M0WUT/Intermediate_PCBs/README.md

# Intermediate_PCBs
Selection of PCBs designed to help with the UK Intermediate Amateur Radio Licence practical requirements
