M0WUT/Intermediate_PCBs/schematic.pdf

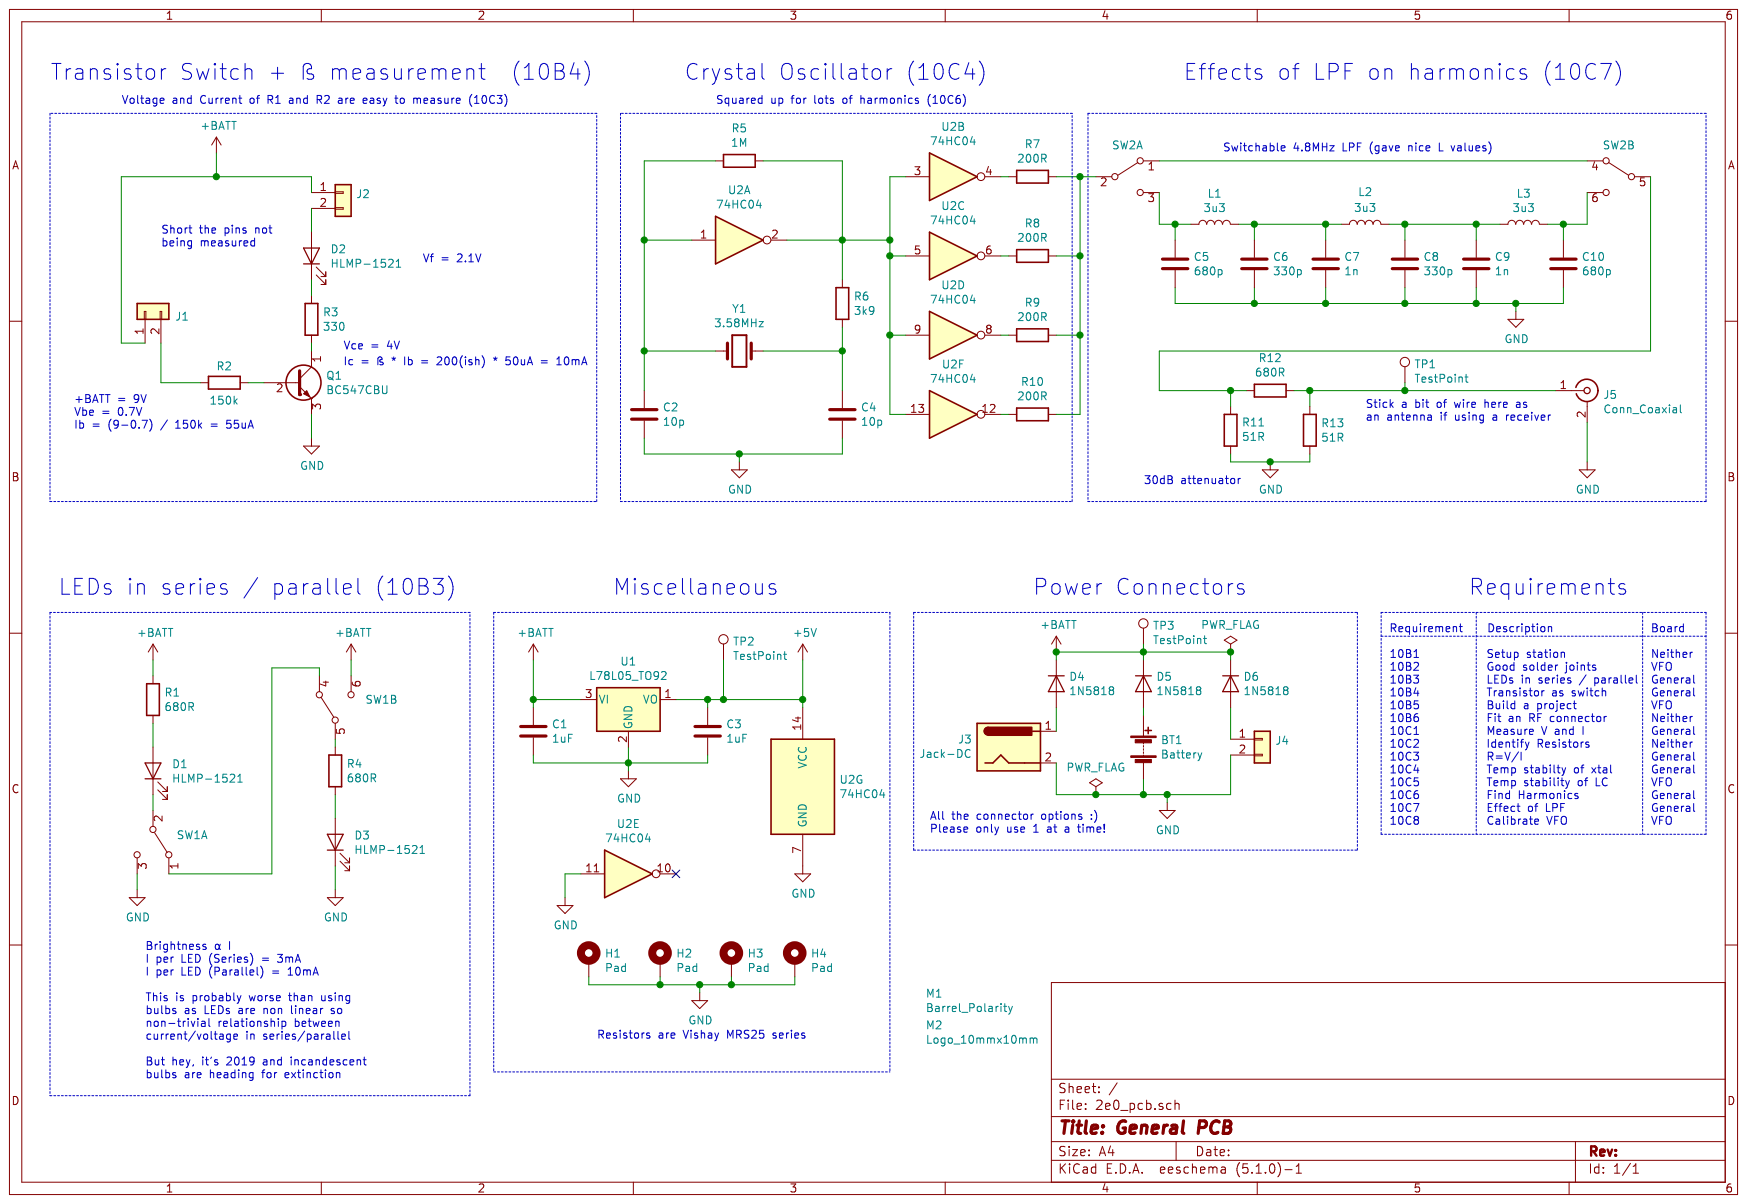
[picture p1: page 1]
