M0WUT/Intermediate_PCBs/2e0_pcb/2e0_pcb.kicad_pcb

## KiCad design 2e0_pcb/2e0_pcb.kicad_pcb (2019-10-28)

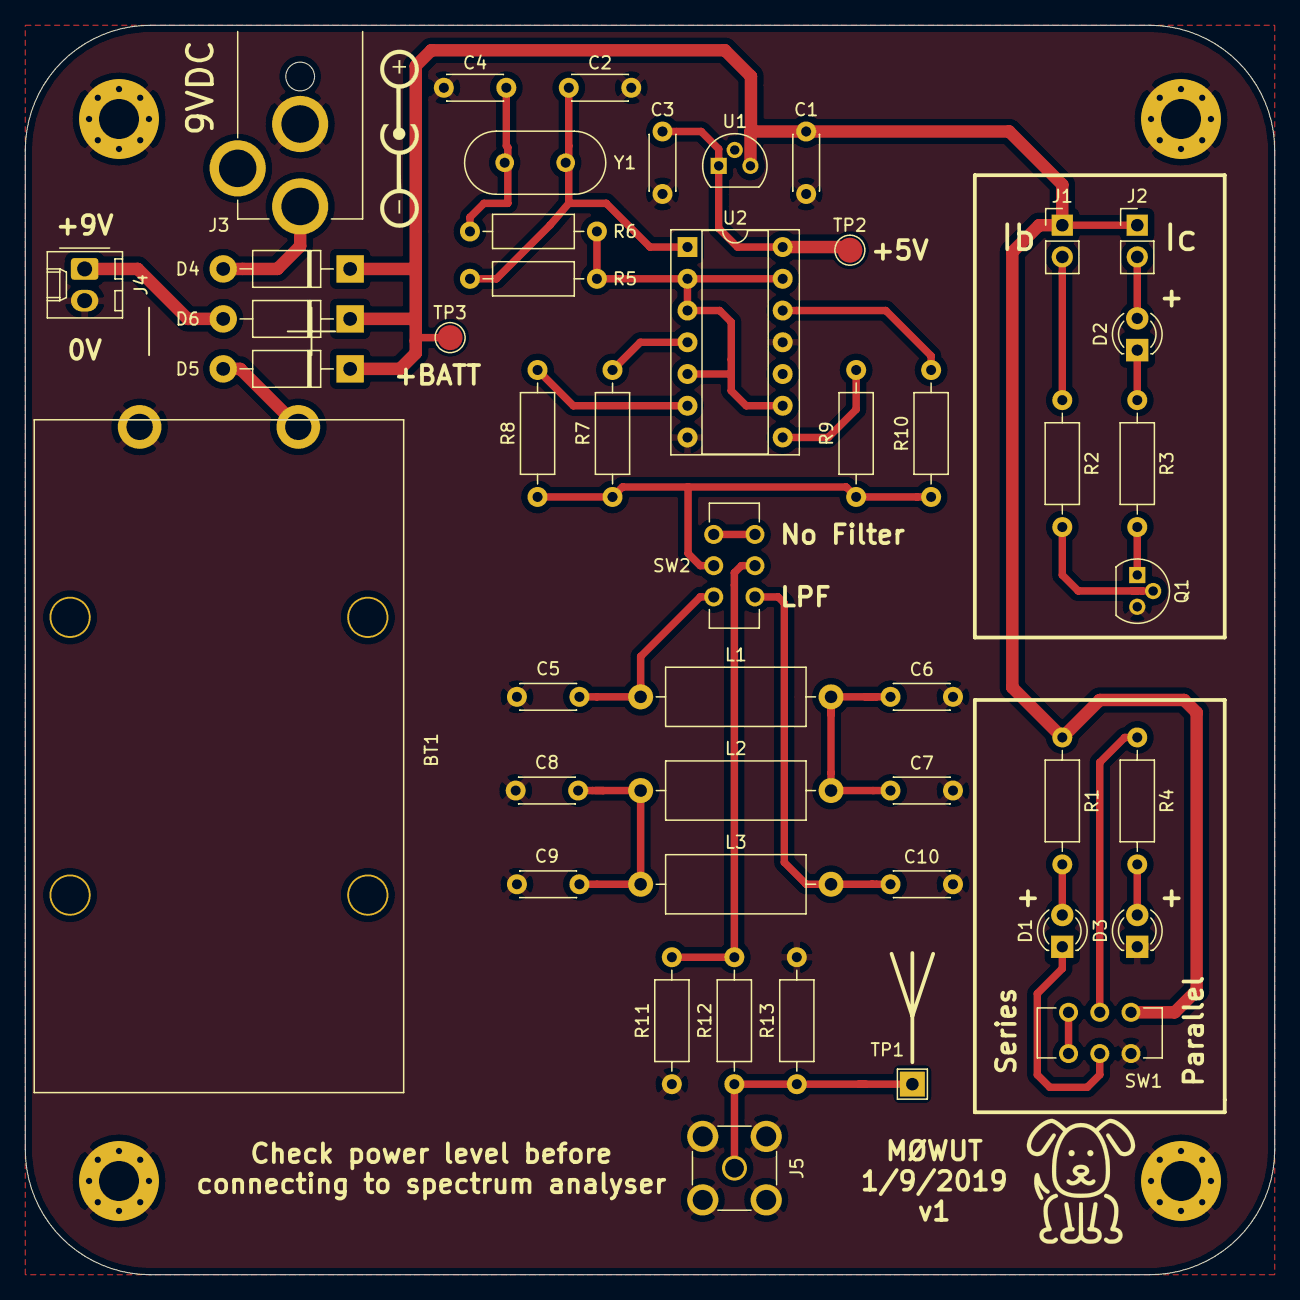
[picture p2: board 2e0_pcb.kicad_pcb from above]

Board: 2 copper layers, 100.0 x 100.0 mm, 53 parts (0 on the bottom side), 31 nets.

Parts:
BT1: Battery; Battery_PP3_Keystone_1294_TH
C1, C3: 1uF; C_Disc_D4.3mm_W1.9mm_P5.00mm
C2, C4: 10p; C_Disc_D4.3mm_W1.9mm_P5.00mm
C5, C10: 680p; C_Disc_D4.3mm_W1.9mm_P5.00mm
C6, C8: 330p; C_Disc_D4.3mm_W1.9mm_P5.00mm
C7, C9: 1n; C_Disc_D4.3mm_W1.9mm_P5.00mm
D1, D2, D3: HLMP-1521; LED_D3.0mm
D4, D5, D6: 1N5818; D_DO-41_SOD81_P10.16mm_Horizontal
H1, H2, H3, H4: Pad; MountingHole_3.2mm_M3_Pad_Via
J1, J2: Conn_01x02; PinHeader_1x02_P2.54mm_Vertical
J3: Jack-DC; Barrel-Jack_Cliff_FC681478_TH
J4: Conn_01x02; Molex_KK-254_AE-6410-02A_1x02_P2.54mm_Vertical
J5: Conn_Coaxial; SMA_TE_5-1814832-1_Vertical
L1, L2, L3: 3u3; L_Axial_L11.0mm_D4.5mm_P15.24mm_Horizontal_Fastron_MECC
M1: Barrel_Polarity
M2: Logo_10mmx10mm
Q1: BC547CBU; TO-92L
R1, R4, R12: 680R; R_Axial_DIN0207_L6.3mm_D2.5mm_P10.16mm_Horizontal
R2: 150k; R_Axial_DIN0207_L6.3mm_D2.5mm_P10.16mm_Horizontal
R3: 330; R_Axial_DIN0207_L6.3mm_D2.5mm_P10.16mm_Horizontal
R5: 1M; R_Axial_DIN0207_L6.3mm_D2.5mm_P10.16mm_Horizontal
R6: 3k9; R_Axial_DIN0207_L6.3mm_D2.5mm_P10.16mm_Horizontal
R7, R8, R9, R10: 200R; R_Axial_DIN0207_L6.3mm_D2.5mm_P10.16mm_Horizontal
R11, R13: 51R; R_Axial_DIN0207_L6.3mm_D2.5mm_P10.16mm_Horizontal
SW1, SW2: SW_DPDT_x2; C+K_Slide_DPDT_JS202011CQN_TH
TP1: TestPoint; TestPoint_THTPad_2.0x2.0mm_Drill1.0mm
TP2, TP3: TestPoint; TestPoint_Pad_D2.0mm
U1: L78L05_TO92; TO-92L
U2: 74HC04; DIP-14_W7.62mm_Socket
Y1: 3.58MHz; Crystal_HC49-U_Vertical

Connections:
+5V: C3.1, TP2.1, U1.1, U2.14
+BATT: C1.1, D4.1, D5.1, D6.1, J1.1, J2.1, R1.1, SW1.6, TP3.1, U1.3
GND: BT1.2, C1.2, C2.2, C3.2, C4.2, C5.2, C6.2, C7.2, C8.2, C9.2, C10.2, D3.1, H1.1, H2.1, H3.1, H4.1, J3.2, J4.2, J5.2, Q1.3, R11.1, R13.2, SW1.3, U1.2, U2.7, U2.11
unnamed: BT1.1, D5.2
unnamed: C2.1, R5.2, U2.1, Y1.1
unnamed: C4.1, R6.2, Y1.2
unnamed: C5.1, L1.1, SW2.3
unnamed: C6.1, C7.1, L1.2, L2.2
unnamed: C8.1, C9.1, L2.1, L3.1
unnamed: C10.1, L3.2, SW2.6
unnamed: D1.1, SW1.2
unnamed: D1.2, R1.2
unnamed: D2.1, R3.1
unnamed: D2.2, J2.2
unnamed: D3.2, R4.2
unnamed: D4.2, J3.1
unnamed: D6.2, J4.1
unnamed: J1.2, R2.1
unnamed: J5.1, R12.1, R13.1, TP1.1
unnamed: Q1.1, R3.2
unnamed: Q1.2, R2.2
unnamed: R4.1, SW1.5
unnamed: R5.1, R6.1, U2.2, U2.3, U2.5, U2.9, U2.13
unnamed: R7.2, U2.4
unnamed: R8.2, U2.6
unnamed: R9.2, U2.8
unnamed: R7.1, R8.1, R9.1, R10.1, SW2.2
unnamed: R10.2, U2.12
unnamed: R11.2, R12.2, SW2.5
unnamed: SW1.1, SW1.4
unnamed: SW2.1, SW2.4
