M0WUT/Intermediate_PCBs/(commit log)

2019-08-29 First draft
    Still not sure what qualifies as one section says "Make a circuit that shows..." Guessing a pre-made board doesn't count
    [2e0_pcb.kicad_pcb, 2e0_pcb.sch]
2019-08-30 first draft complete
    [2e0_pcb.sch]
2019-08-30 minor aesthetic updates
    [2e0_pcb.sch]
2019-08-30 stopped input pin from floating
    [2e0_pcb.sch]
2019-09-01 Release 1
    Boards ordered 1/9/2018
    [2e0_pcb.kicad_pcb, 2e0_pcb.sch]
2019-10-28 Added changes from testing
    [2e0_pcb.kicad_pcb, 2e0_pcb.sch]
2019-11-06 added PDF schematic
